awende/Cherry_MX_Keyboard/Schematic/Cherry_MX_Keyboard_Schematic.png

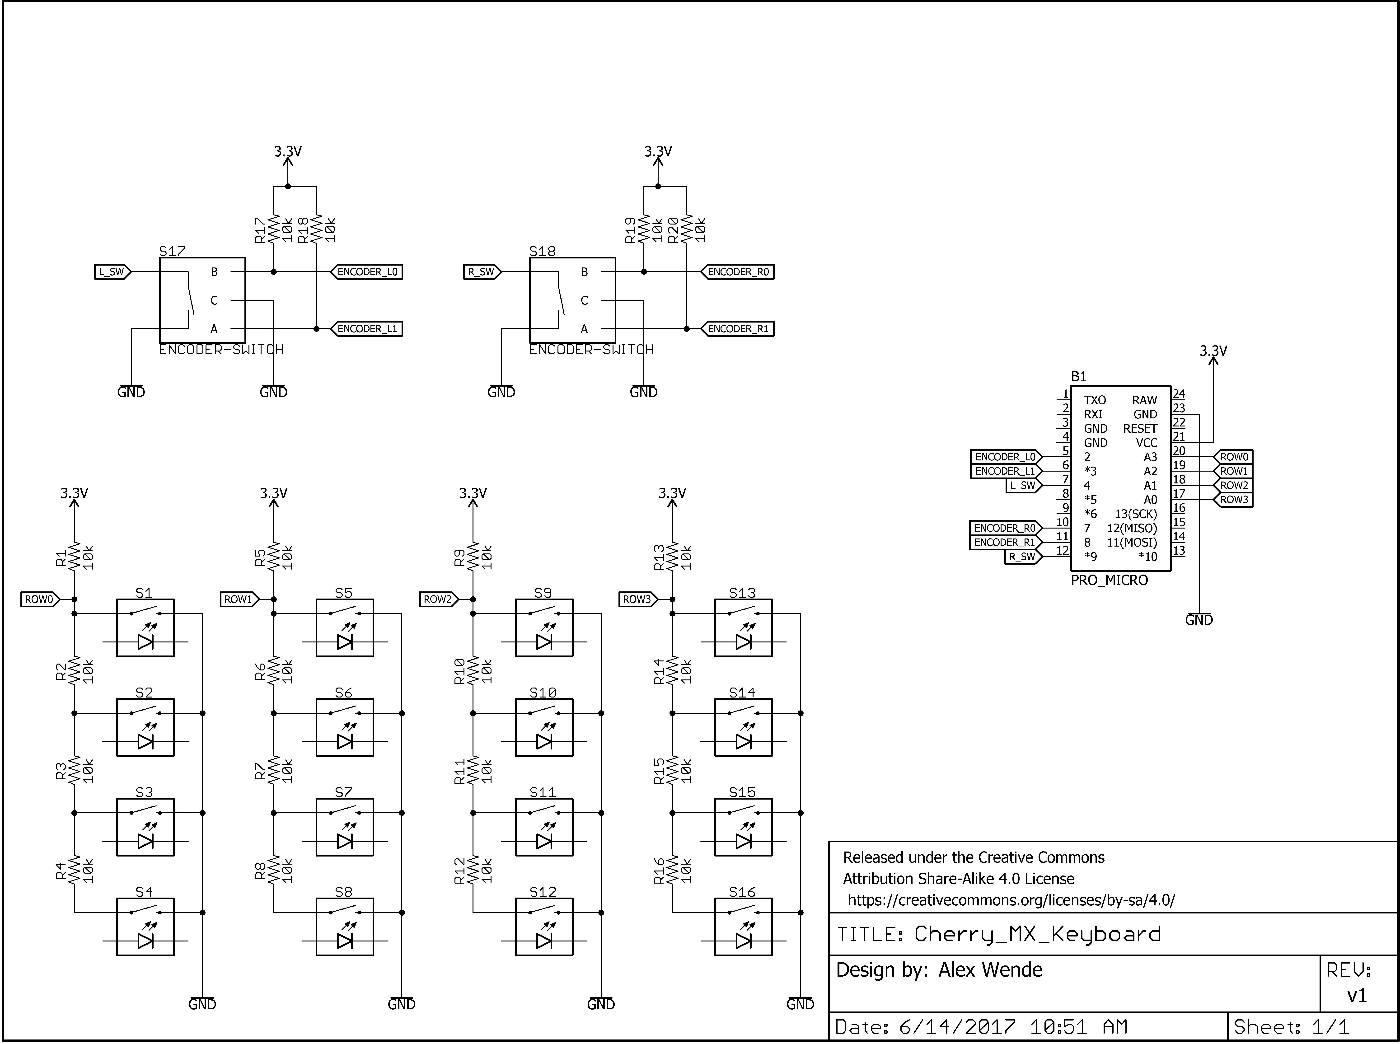
Schematic/Cherry_MX_Keyboard_Schematic.png
