awende/Cherry_MX_Keyboard/Schematic/Cherry_MX_Keyboard.sch

## EAGLE design Schematic/Cherry_MX_Keyboard.sch (2017-06-14)

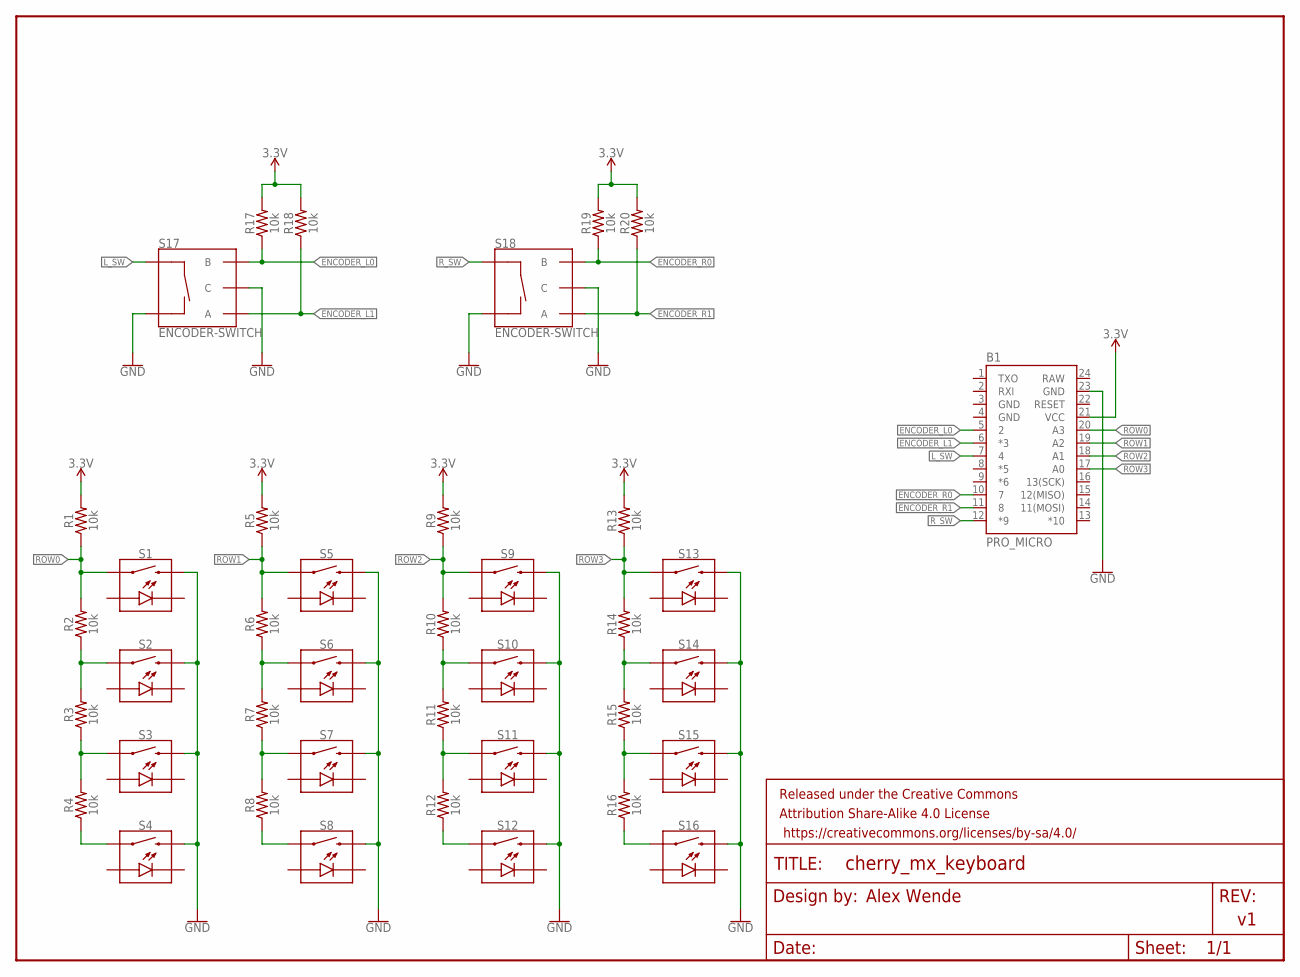
[picture p2: schematic Cherry_MX_Keyboard.sch]

Parts:
B1: PRO_MICRO; SPARKFUN_PRO_MICRO
FRAME1: FRAME-LETTERNO_PACKAGE; DUMMY
R1, R2, R3, R4, R5, R6, R7, R8, R9, R10, R11, R12, R13, R14, R15, R16, R17, R18, R19, R20: 10k; 0603
S1, S2, S3, S4, S5, S6, S7, S8, S9, S10, S11, S12, S13, S14, S15, S16: MOMENTARY-SWITCH-SPST-LED-PTH-CHERRY; CHERRY-MX-LED
S17, S18: ENCODER-SWITCH; ROTARY_ENC_PLAIN

Connections:
3.3V: B1.21 (VCC), R1.2, R5.2, R9.2, R13.2, R17.2, R18.2, R19.2, R20.2
ENCODER_L0: B1.5 (2), R17.1, S17.B
ENCODER_L1: B1.6 (*3), R18.1, S17.A
ENCODER_R0: B1.10 (7), R19.1, S18.B
ENCODER_R1: B1.11 (8), R20.1, S18.A
GND: B1.23 (GND), S1.S2 (2), S2.S2 (2), S3.S2 (2), S4.S2 (2), S5.S2 (2), S6.S2 (2), S7.S2 (2), S8.S2 (2), S9.S2 (2), S10.S2 (2), S11.S2 (2), S12.S2 (2), S13.S2 (2), S14.S2 (2), S15.S2 (2), S16.S2 (2), S17.C, S17.SW-, S18.C, S18.SW-
L_SW: B1.7 (4), S17.SW+
unnamed: R4.1, S4.S1 (1)
unnamed: R3.1, R4.2, S3.S1 (1)
unnamed: R2.1, R3.2, S2.S1 (1)
unnamed: R8.1, S8.S1 (1)
unnamed: R7.1, R8.2, S7.S1 (1)
unnamed: R6.1, R7.2, S6.S1 (1)
unnamed: R12.1, S12.S1 (1)
unnamed: R11.1, R12.2, S11.S1 (1)
unnamed: R10.1, R11.2, S10.S1 (1)
unnamed: R16.1, S16.S1 (1)
unnamed: R15.1, R16.2, S15.S1 (1)
unnamed: R14.1, R15.2, S14.S1 (1)
ROW0: B1.20 (A3), R1.1, R2.2, S1.S1 (1)
ROW1: B1.19 (A2), R5.1, R6.2, S5.S1 (1)
ROW2: B1.18 (A1), R9.1, R10.2, S9.S1 (1)
ROW3: B1.17 (A0), R13.1, R14.2, S13.S1 (1)
R_SW: B1.12 (*9), S18.SW+

Notes on the sheet:
Alex Wende
