awende/Cherry_MX_Keyboard/(threads)

Thread 1 (2017-07-29):

No PCB board

phana007, 2017-07-29:
Hi mate,
Are you able to upload the pcb layout for eagle?

awende, 2017-07-31:
The buttons are mounted to the laser cut plastic using the cherry mx mechanical retention clips. All the electrical connections were made using point-to-point soldering as shown below:
<a href="http://imgur.com/r2xG7RO">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</a>

phana007, 2017-07-31:
Nice! Thanks I'll give this build a go. Cheers
